dtvp/coringa-m0/Hardware/Docs/coringaM0-ASSY.pdf

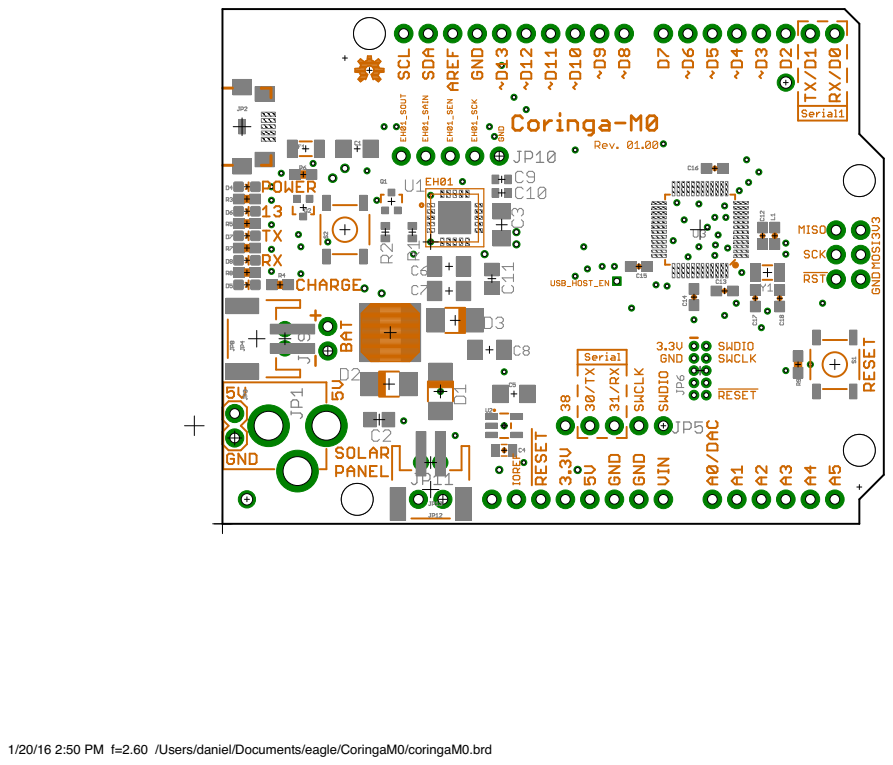
[picture p1: page 1]

1/20/16 2:50 PM f=2.60 /Users/daniel/Documents/eagle/CoringaM0/coringaM0.brd
