dtvp/coringa-m0/Hardware/Docs/coringaM0-SCH.pdf

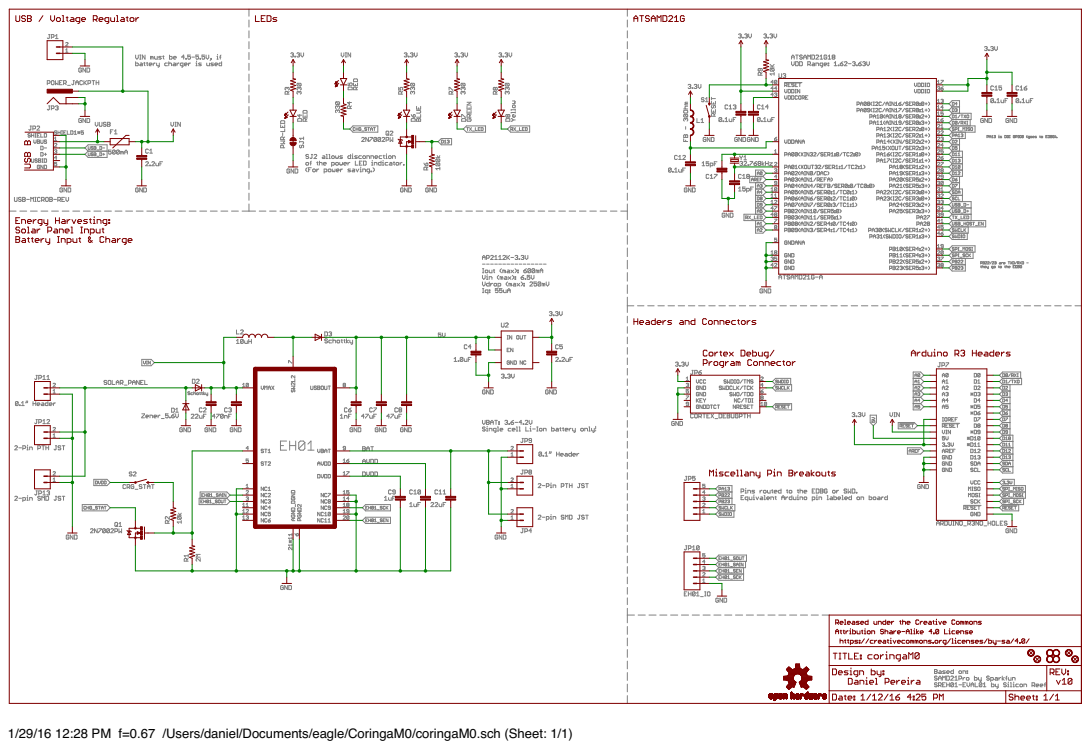
[picture p2: page 1]

1/29/16 12:28 PM f=0.67 /Users/daniel/Documents/eagle/CoringaM0/coringaM0.sch (Sheet: 1/1)
