dtvp/coringa-m0/Hardware/Eagle/coringaM0.brd

## EAGLE design Hardware/Eagle/coringaM0.brd (2016-01-29)

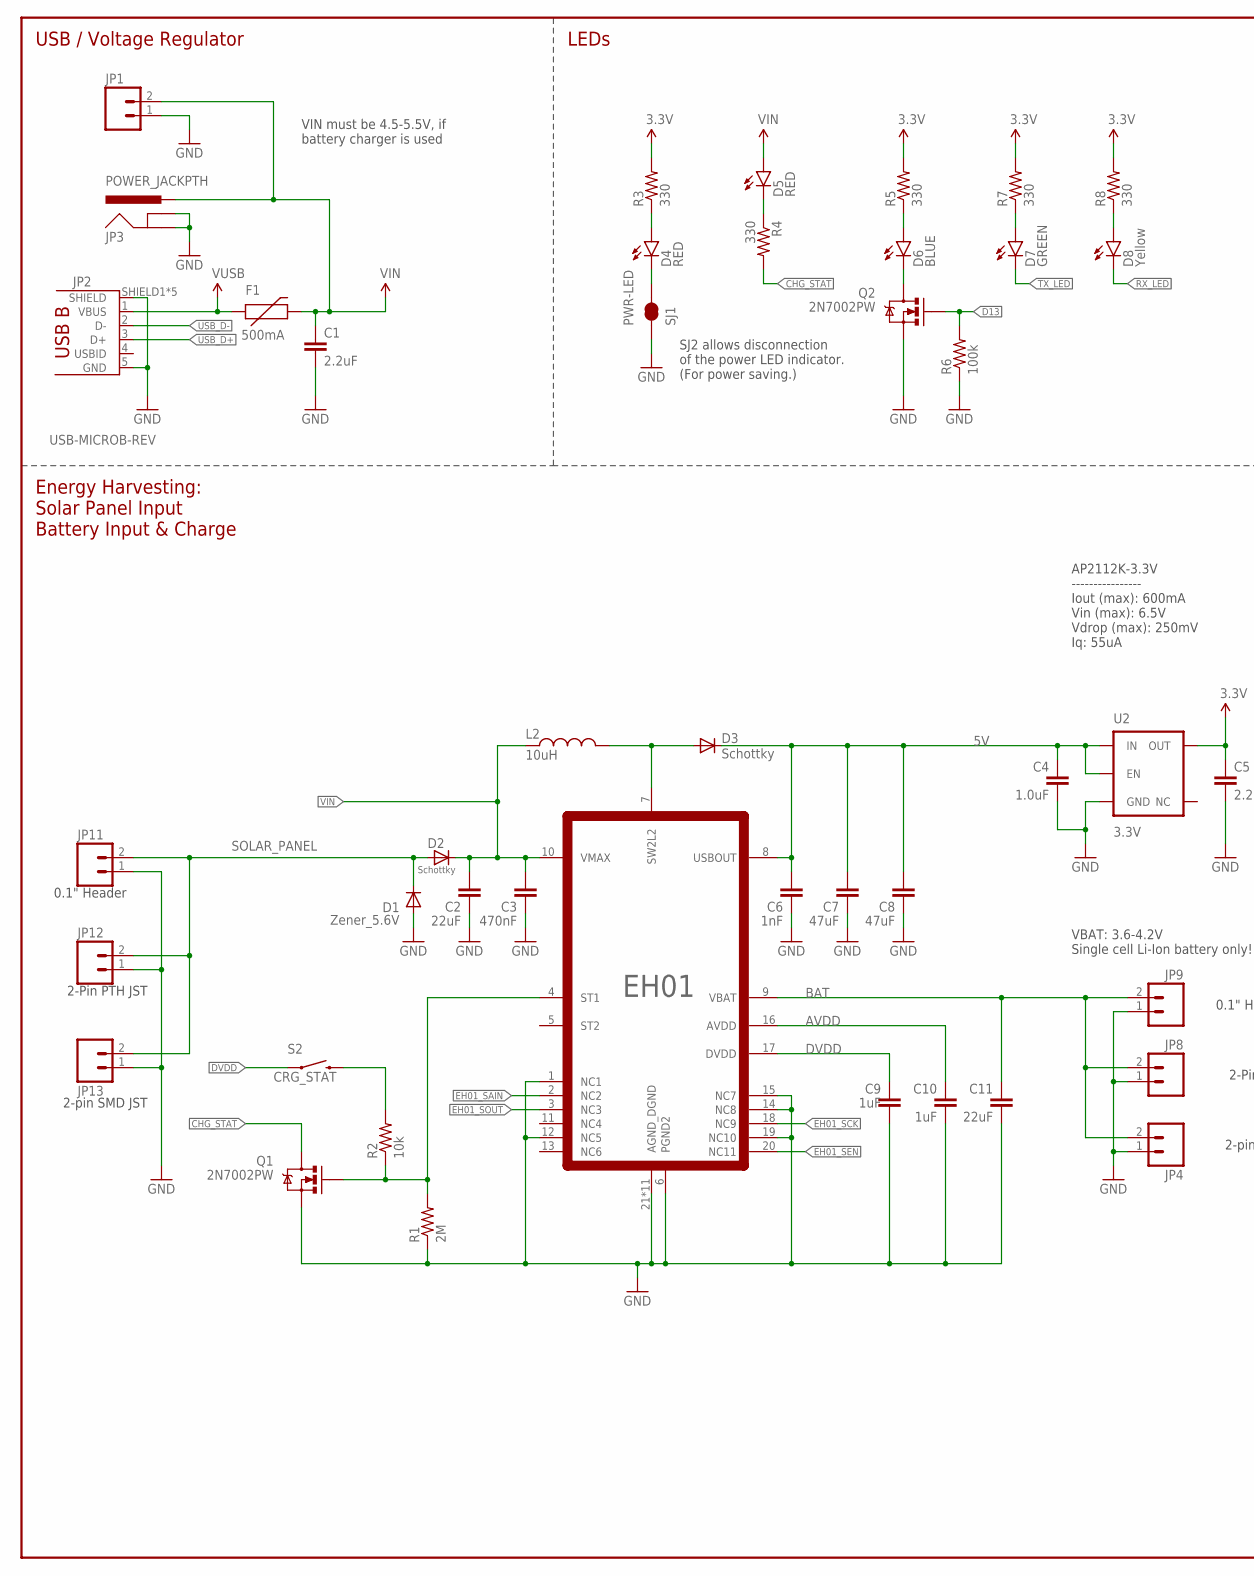
[picture p3: schematic coringaM0.sch, part in row 1, column 1]

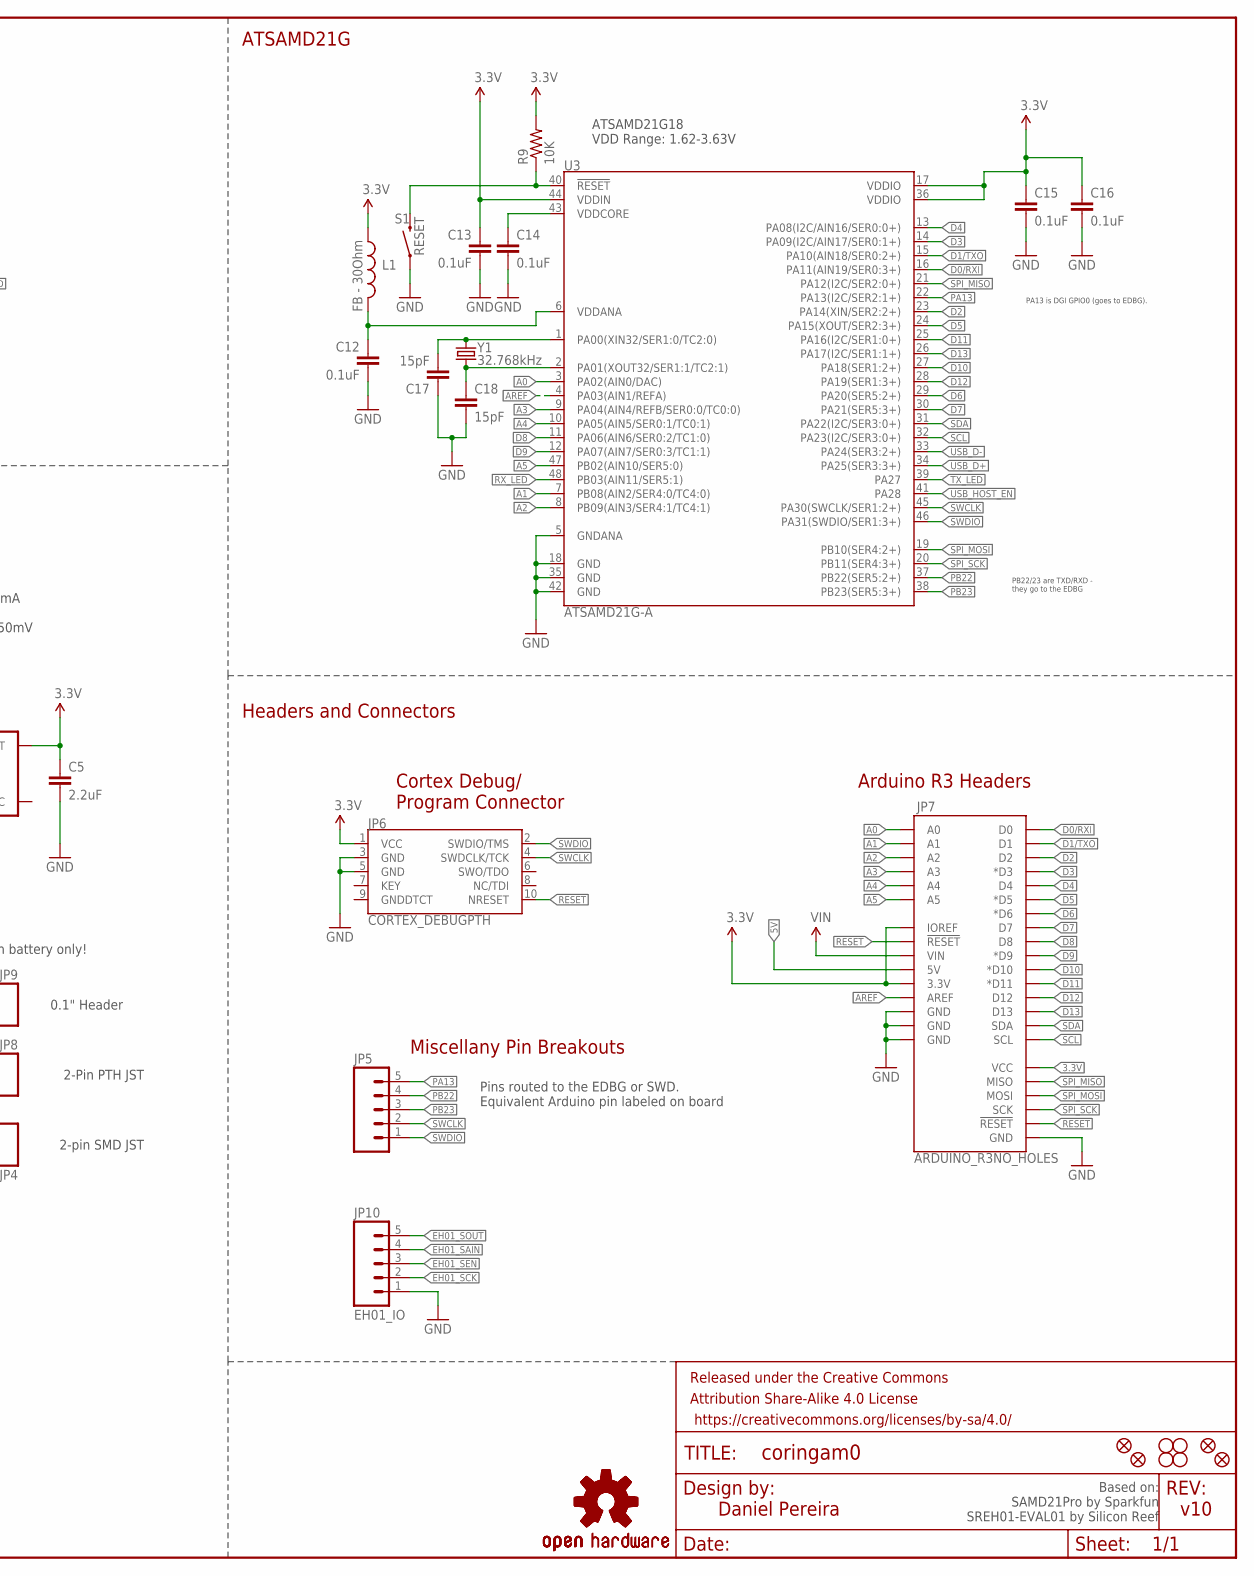
[picture p4: schematic coringaM0.sch, part in row 1, column 2]

Parts:
C1, C5: 2.2uF; 1206
C2, C11: 22uF; RCL_C0805
C3: 470nF; RCL_C1206
C4: 1.0uF; 0805-CAP
C6: 1nF; RCL_C1206K
C7, C8: 47uF; RCL_C1206K
C9, C10: 1uF; RCL_C0402
C12, C13, C14, C15, C16: 0.1uF; 0603-CAP
C17, C18: 15pF; 0603-CAP
D1: Zener_5.6V; DO-214AC
D2, D3: Schottky; DO-214AC
D4, D5: RED; LED-0603
D6: BLUE; LED-0603
D7: GREEN; LED-0603
D8: Yellow; LED-0603
F1: 500mA; PTC-1206
FD1, FD2: FIDUCIAL-VIA
FID1, FID2: FIDUCIAL1X2; FIDUCIAL-1X2
FRAME1: FRAME-LEDGER; CREATIVE_COMMONS
JP1: M02PTH; 1X02
JP2: USB-MICROB-REV; USB-B-MICRO-REV-SMD
JP3: POWER_JACKPTH; POWER_JACK_PTH
JP4, JP13: M02-JST-2MM-SMT; JST-2-SMD
JP5: M05NO_SILK; 1X05_NO_SILK
JP6: CORTEX_DEBUGPTH; 2X5-PTH-1.27MM
JP7: ARDUINO_R3NO_HOLES; ARDUINO_R3_NO_HOLES
JP8, JP12: M02-JST-2-PTH-NO_SILK; JST-2-PTH-NS
JP9, JP11: M021X02_NO_SILK; 1X02_NO_SILK
JP10: EH01_IO; 1X05_NO_SILK
L1: FB - 30Ohm; 0603
L2: 10uH; SRN4065-100M
LOGO3: OSHW-LOGOS; OSHW-LOGO-S
LOGO4: OSHW-LOGOL; OSHW-LOGO-L
Q1, Q2: 2N7002PW; SOT323
R1: 2M; RESISTOR_R0402
R2: 10k; RESISTOR_R0402
R3, R4, R5, R7, R8: 330; 0603-RES
R6: 100k; 0603-RES
R9: 10K; 0603-RES
S1: RESET; TACTILE-SWITCH-SMD
S2: CRG_STAT; TACTILE-SWITCH-SMD
SJ1: PWR-LED; PAD-JUMPER-2-NC_BY_TRACE_NO_SILK
STANDOFF1, STANDOFF2, STANDOFF3, STANDOFF4: STAND-OFF
U1: EH01; QFN20
U2: 3.3V; SOT23-5
U3: ATSAMD21G-A; TQFP-48
Y1: 32.768kHz; CRYSTAL-SMD-3.2X1.5MM

Connections:
3.3V: C5.1, C13.1, C15.1, C16.1, JP6.1 (VCC), JP7.3.3V, JP7.IOREF, JP7.VCC, L1.1, R3.2, R5.2, R7.2, R8.2, R9.2, U2.5 (OUT), U3.17 (VDDIO), U3.36 (VDDIO), U3.44 (VDDIN)
5V: C4.1, C6.2, C7.2, C8.2, D3.C, JP7.5V, U1.8 (USBOUT), U2.1 (IN), U2.3 (EN)
!RESET: JP6.10 (NRESET), JP7.RESET@1 (!RESET!), JP7.RESET@2 (!RESET!), R9.1, S1.3 (2), U3.40 (!RESET!)
A0: JP7.A0, U3.3 (PA02(AIN0/DAC))
A1: JP7.A1, U3.7 (PB08(AIN2/SER4:0/TC4:0))
A2: JP7.A2, U3.8 (PB09(AIN3/SER4:1/TC4:1))
A3: JP7.A3, U3.9 (PA04(AIN4/REFB/SER0:0/TC0:0))
A4: JP7.A4, U3.10 (PA05(AIN5/SER0:1/TC0:1))
A5: JP7.A5, U3.47 (PB02(AIN10/SER5:0))
AREF: JP7.AREF, U3.4 (PA03(AIN1/REFA))
AVDD: C10.2, U1.16 (AVDD)
BAT: C11.2, JP4.2 (1), JP8.2, JP9.2, U1.9 (VBAT)
CHG_STAT: Q1.3 (D), R4.2
D0/RXI: JP7.D0, U3.16 (PA11(AIN19/SER0:3+))
D1/TXO: JP7.D1, U3.15 (PA10(AIN18/SER0:2+))
D2: JP7.D2, U3.23 (PA14(XIN/SER2:2+))
D3: JP7.D3 (*D3), U3.14 (PA09(I2C/AIN17/SER0:1+))
D4: JP7.D4, U3.13 (PA08(I2C/AIN16/SER0:0+))
D5: JP7.D5 (*D5), U3.24 (PA15(XOUT/SER2:3+))
D6: JP7.D6 (*D6), U3.29 (PA20(SER5:2+))
D7: JP7.D7, U3.30 (PA21(SER5:3+))
D8: JP7.D8, U3.11 (PA06(AIN6/SER0:2/TC1:0))
D9: JP7.D9 (*D9), U3.12 (PA07(AIN7/SER0:3/TC1:1))
D10: JP7.D10 (*D10), U3.27 (PA18(SER1:2+))
D11: JP7.D11 (*D11), U3.25 (PA16(I2C/SER1:0+))
D12: JP7.D12, U3.28 (PA19(SER1:3+))
D13: JP7.D13, Q2.1 (G), R6.2, U3.26 (PA17(I2C/SER1:1+))
DVDD: C9.2, S2.1, U1.17 (DVDD)
EH01_SAIN: JP10.4, U1.2 (NC2)
EH01_SCK: JP10.2, U1.18 (NC9)
EH01_SEN: JP10.3, U1.20 (NC11)
EH01_SOUT: JP10.5, U1.3 (NC3)
EH01_ST1: Q1.1 (G), R1.2, R2.1, U1.4 (ST1)
EH01_SW: D3.A, L2.P$2 (2), U1.7 (SW2L2)
GND: C1.2, C2.1, C3.1, C4.2, C5.2, C6.1, C7.1, C8.1, C9.1, C10.1, C11.1, C12.2, C13.2, C14.2, C15.2, C16.2, C17.1, C18.2, D1.A, JP1.1, JP2.5 (GND), JP2.SHIELD1 (SHIELD), JP2.SHIELD2 (SHIELD), JP2.SHIELD3 (SHIELD), JP2.SHIELD4 (SHIELD), JP2.SHIELD5 (SHIELD), JP3.GND, JP3.GNDBREAK, JP4.1 (2), JP6.3 (GND), JP6.5 (GND), JP7.GND@1 (GND), JP7.GND@2 (GND), JP7.GND@3 (GND), JP7.GND@4 (GND), JP8.1, JP9.1, JP10.1, JP11.1, JP12.1, JP13.1 (2), Q1.2 (S), Q2.2 (S), R1.1, R6.1, S1.1, SJ1.1, U1.1 (NC1), U1.6 (PGND2), U1.12 (NC5), U1.14 (NC8), U1.15 (NC7), U1.19 (NC10), U1.21 (AGND_DGND), U1.22 (AGND_DGND), U1.P$1 (AGND_DGND), U1.P$2 (AGND_DGND), U1.P$3 (AGND_DGND), U1.P$4 (AGND_DGND), U1.P$5 (AGND_DGND), U1.P$6 (AGND_DGND), U1.P$7 (AGND_DGND), U1.P$8 (AGND_DGND), U1.P$9 (AGND_DGND), U2.2 (GND), U3.5 (GNDANA), U3.18 (GND), U3.35 (GND), U3.42 (GND)
unnamed: C17.2, U3.1 (PA00(XIN32/SER1:0/TC2:0)), Y1.P$2 (2)
unnamed: D6.C, Q2.3 (D)
unnamed: C18.1, U3.2 (PA01(XOUT32/SER1:1/TC2:1)), Y1.P$1 (1)
unnamed: D4.A, R3.1
unnamed: D6.A, R5.1
unnamed: D5.C, R4.1
unnamed: D7.A, R7.1
unnamed: D8.A, R8.1
unnamed: D4.C, SJ1.2
unnamed: R2.2, S2.3 (2)
PA13: JP5.5, U3.22 (PA13(I2C/SER2:1+))
PB22: JP5.4, U3.37 (PB22(SER5:2+))
PB23: JP5.3, U3.38 (PB23(SER5:3+))
RX_LED: D8.C, U3.48 (PB03(AIN11/SER5:1))
SCL: JP7.SCL, U3.32 (PA23(I2C/SER3:0+))
SDA: JP7.SDA, U3.31 (PA22(I2C/SER3:0+))
SOLAR_PANEL: D1.C, D2.A, JP11.2, JP12.2, JP13.2 (1)
SPI_MISO: JP7.MISO, U3.21 (PA12(I2C/SER2:0+))
SPI_MOSI: JP7.MOSI, U3.19 (PB10(SER4:2+))
SPI_SCK: JP7.SCK, U3.20 (PB11(SER4:3+))
SWCLK: JP5.2, JP6.4 (SWDCLK/TCK), U3.45 (PA30(SWCLK/SER1:2+))
SWDIO: JP5.1, JP6.2 (SWDIO/TMS), U3.46 (PA31(SWDIO/SER1:3+))
TX_LED: D7.C, U3.39 (PA27)
USB_D+: JP2.3 (D+), U3.34 (PA25(SER3:3+))
USB_D-: JP2.2 (D-), U3.33 (PA24(SER3:2+))
USB_HOST_EN: U3.41 (PA28)
VDDANA: C12.1, L1.2, U3.6 (VDDANA)
VDDCORE: C14.1, U3.43 (VDDCORE)
VIN: C1.1, C2.2, C3.2, D2.C, D5.A, F1.2, JP1.2, JP3.PWR, JP7.VIN, L2.P$1 (1), U1.10 (VMAX)
VUSB: F1.1, JP2.1 (VBUS)

Notes on the sheet:
PB22/23 are TXD/RXD - they go to the EDBG
PA13 is DGI GPIO0 (goes to EDBG).
USB / Voltage Regulator
LEDs
Cortex Debug/ Program Connector
Arduino R3 Headers
ATSAMD21G
Daniel Pereira
v10
Energy Harvesting: Solar Panel Input Battery Input & Charge
SJ2 allows disconnection of the power LED indicator. (For power saving.)
Miscellany Pin Breakouts
Headers and Connectors
VIN must be 4.5-5.5V, if battery charger is used
ATSAMD21G18 VDD Range: 1.62-3.63V
Based on: SAMD21Pro by Sparkfun SREH01-EVAL01 by Silicon Reef
0.1" Header
2-Pin PTH JST
2-pin SMD JST
AP2112K-3.3V ---------------- Iout (max): 600mA Vin (max): 6.5V Vdrop (max): 250mV Iq: 55uA
Pins routed to the EDBG or SWD. Equivalent Arduino pin labeled on board
VBAT: 3.6-4.2V Single cell Li-Ion battery only\!

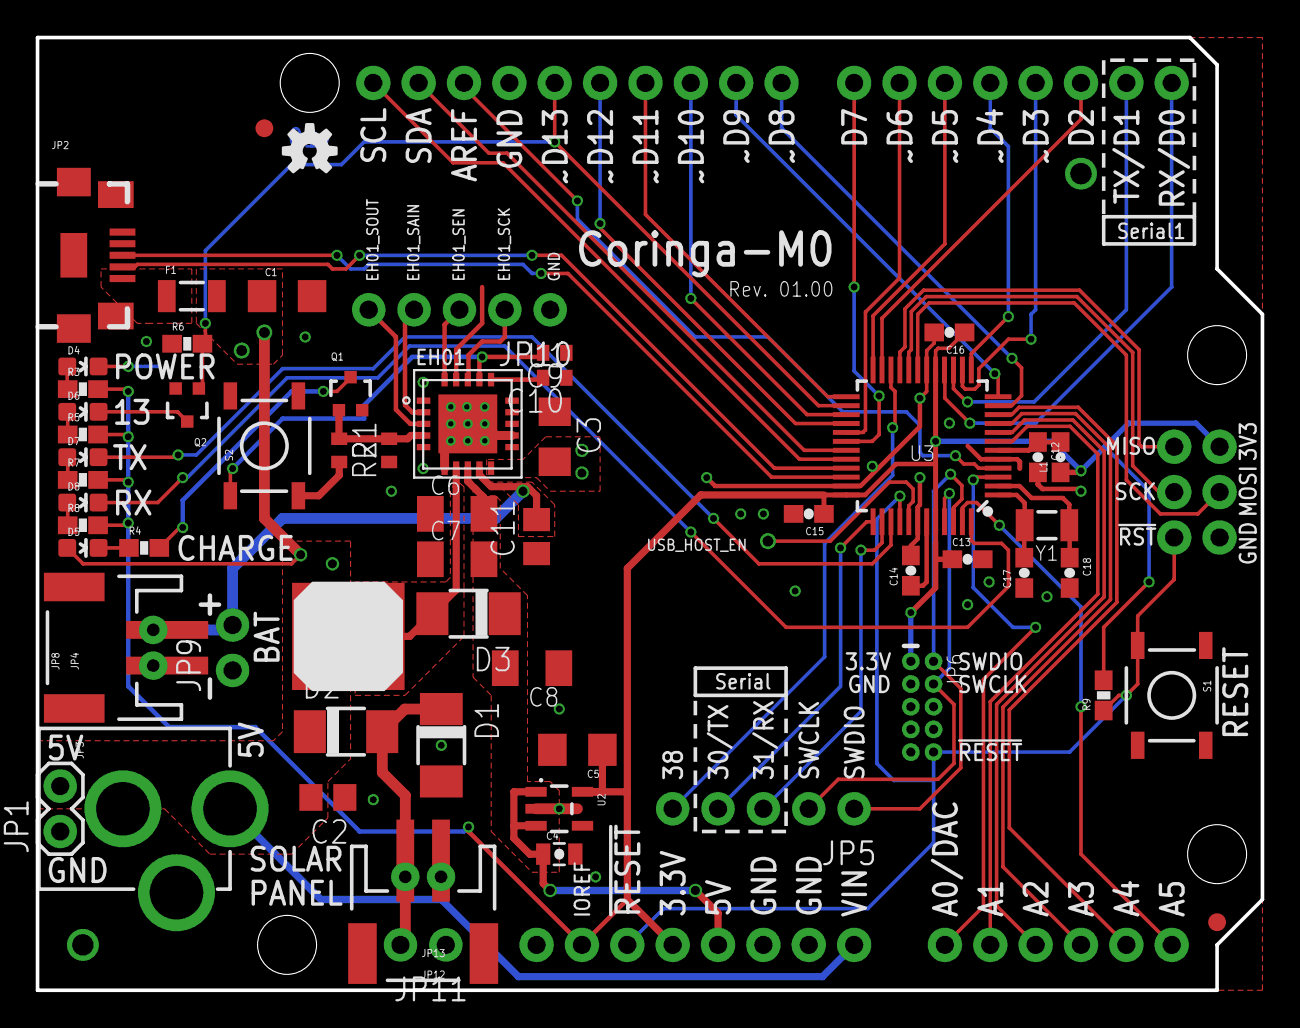
[picture p5: board coringaM0.brd from above]

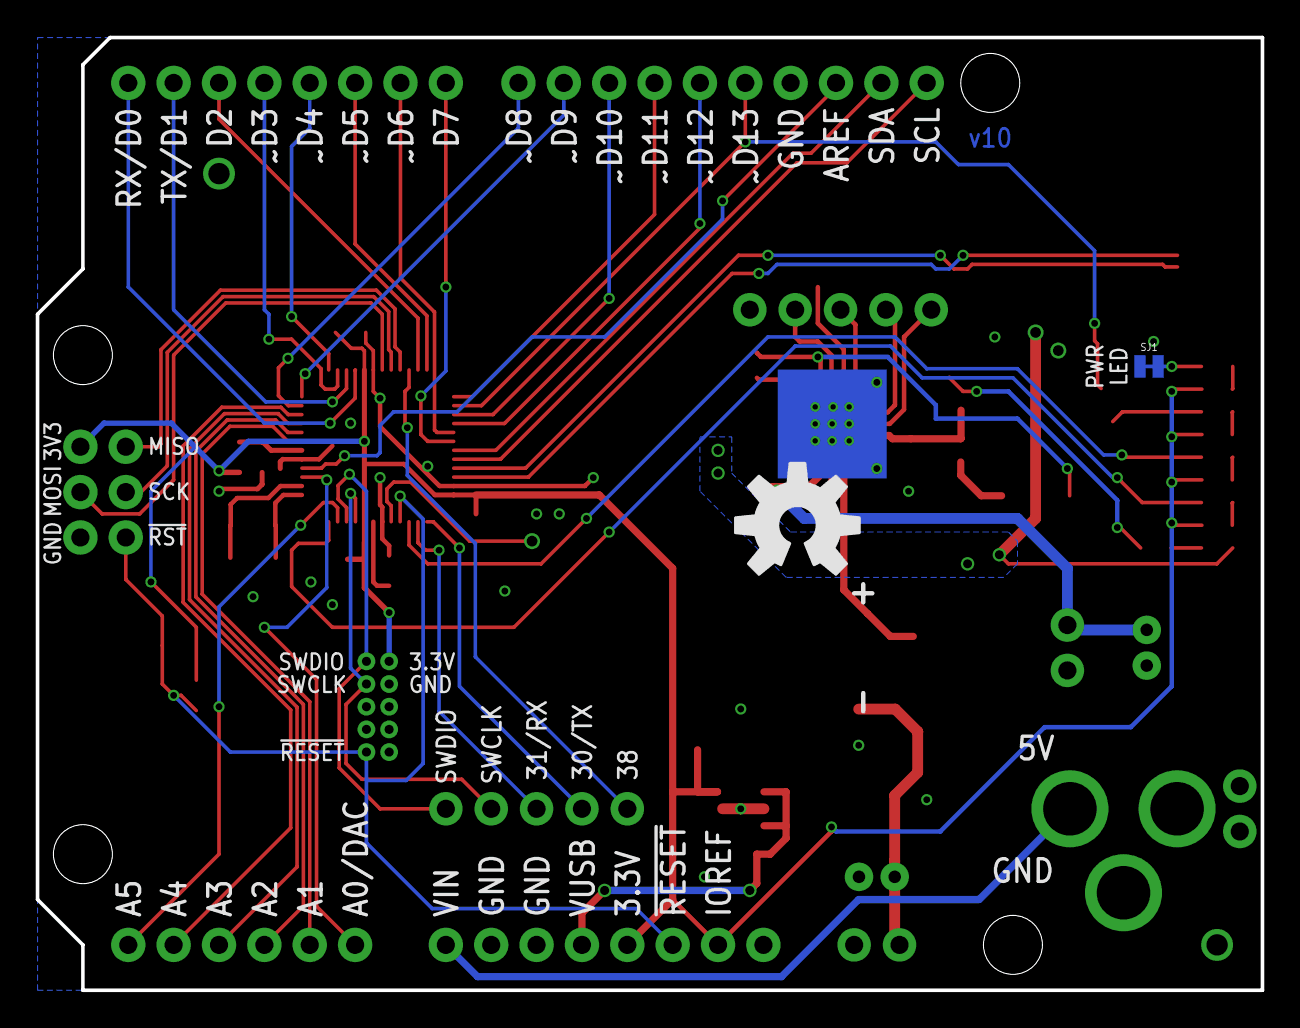
[picture p6: board coringaM0.brd from below]

Board: 2 copper layers, 68.6 x 53.3 mm, 71 parts (2 on the bottom side), 64 nets.
