dtvp/coringa-m0/Firmware/BlinkD13/BlinkD13.ino

// the setup routine runs once when you press reset:
void setup() {
  // initialize digital pin 13 as an output.
  pinMode(13, OUTPUT);
}

// the loop routine runs over and over again forever:
void loop() {
  digitalWrite(13, HIGH);   // turn the LED on (HIGH is the voltage level)
  delay(500);              // wait for a second
  digitalWrite(13, LOW);    // turn the LED off by making the voltage LOW
  delay(500);              // wait for a second
}
